Nanyang-Venture-Formula/NVF-Kicad/README.md

# NVF-Kicad
General Kicad Library for electrical components for use in NVF

## Setup

add `NVF_KICAD_DIR` alias to library where this directory is located
