Nanyang-Venture-Formula/NVF-Kicad/3dmodels/2.54mm/01x08-10.5mmLeg.step

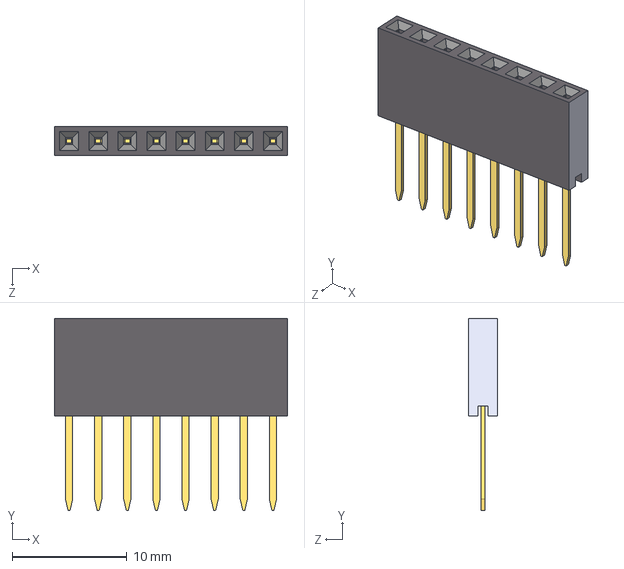
[picture p1: CAD file, 2024-02-09]
3dmodels/2.54mm/01x08-10.5mmLeg.step
20.3 x 16.8 x 2.54 mm
