Nanyang-Venture-Formula/NVF-Kicad/3dmodels/JST/PHD/B8B-PHDSS.step

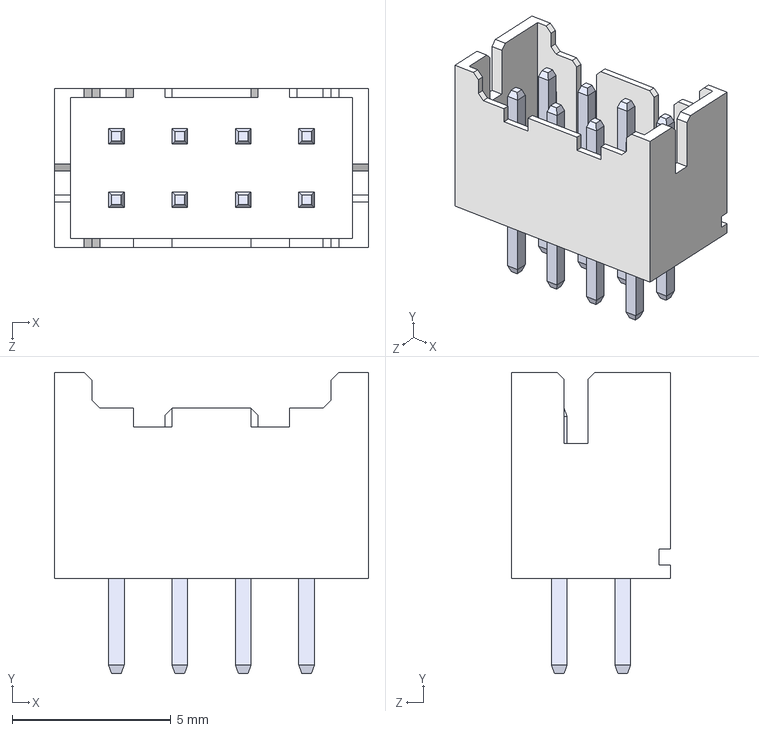
[picture p2: CAD file, 2024-02-05]
3dmodels/JST/PHD/B8B-PHDSS.step
9.90 x 9.50 x 5.00 mm
BxB-PHDSS_8
pin^BxB-PHDSS ass x 8
