Nanyang-Venture-Formula/NVF-Kicad/3dmodels/LED/7Segment-4Digits.step

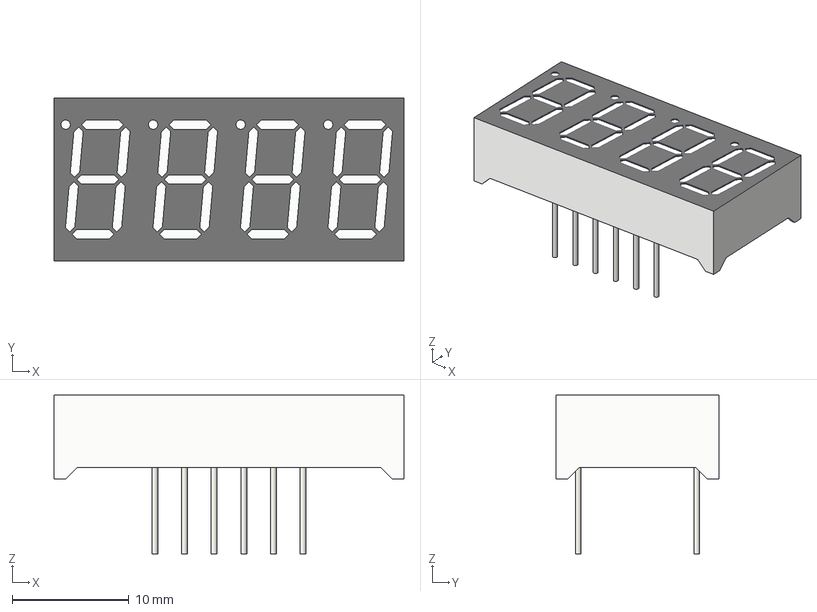
[picture p3: CAD file, 2024-02-09]
3dmodels/LED/7Segment-4Digits.step
30.0 x 14.0 x 13.6 mm
