Nanyang-Venture-Formula/NVF-Kicad/3dmodels/Potentiometer/3362P-1-103LF.step

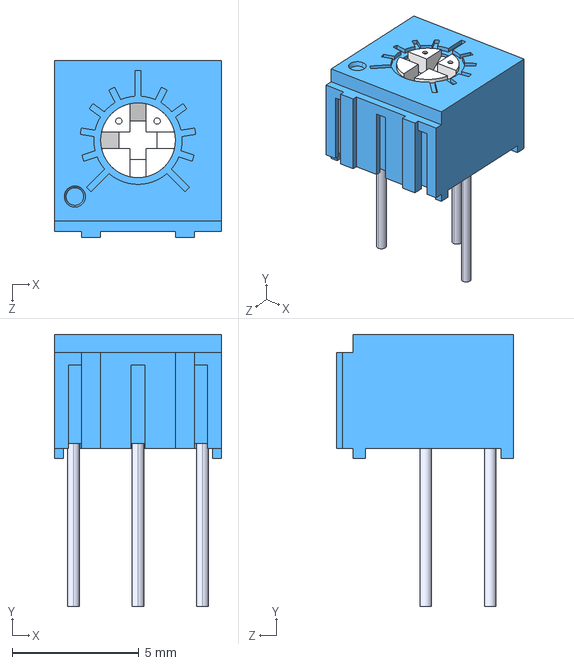
[picture p4: CAD file, 2024-02-09]
3dmodels/Potentiometer/3362P-1-103LF.step
6.60 x 10.7 x 6.99 mm
