Nanyang-Venture-Formula/NVF-Kicad/3dmodels/Rotary Encoder/EC11-THT-20K-thread-black.step

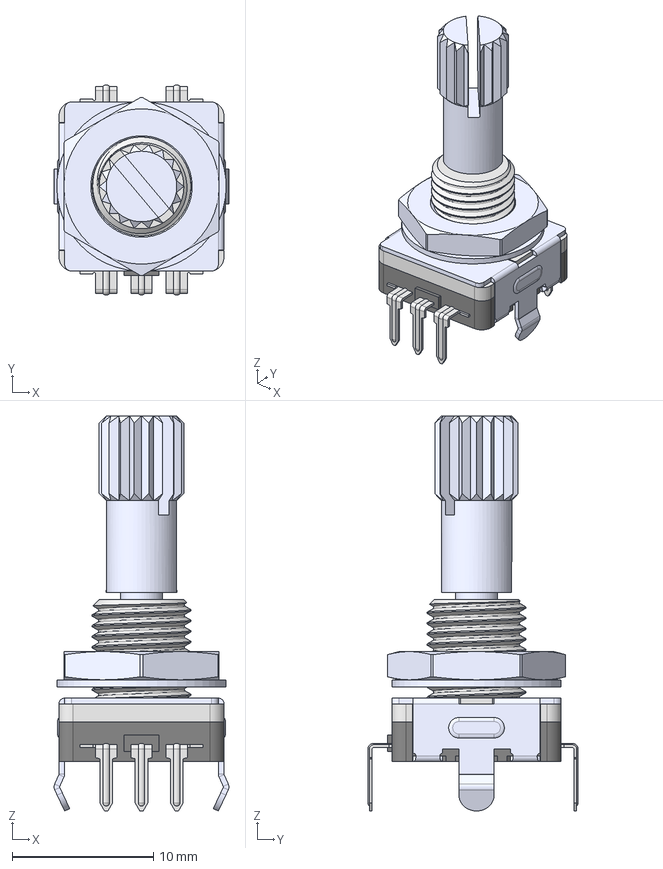
[picture p5: CAD file, 2024-02-09]
3dmodels/Rotary Encoder/EC11-THT-20K-thread-black.step
12.4 x 14.9 x 28.0 mm
Lb7 TH
20K
EC11-Housing-THT
