Nanyang-Venture-Formula/NVF-Kicad/3dmodels/SD/TF-01A.step

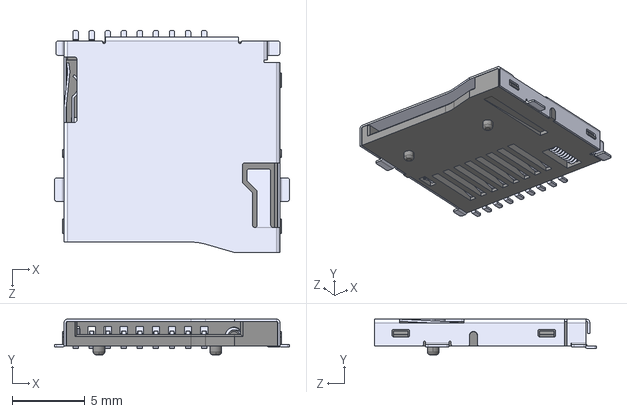
[picture p6: CAD file, 2024-01-23]
3dmodels/SD/TF-01A.step
16.1 x 2.45 x 15.2 mm
