Nanyang-Venture-Formula/NVF-Kicad/3dmodels/Switch/TS-1187A-B-A-B.step

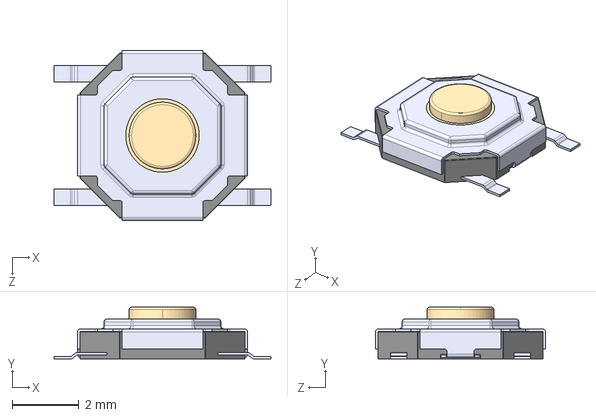
[picture p7: CAD file, 2024-01-23]
3dmodels/Switch/TS-1187A-B-A-B.step
6.50 x 1.55 x 5.10 mm
