Nanyang-Venture-Formula/NVF-Kicad/3dmodels/Fuse/Fuse-Holder/MCCQ-122.step

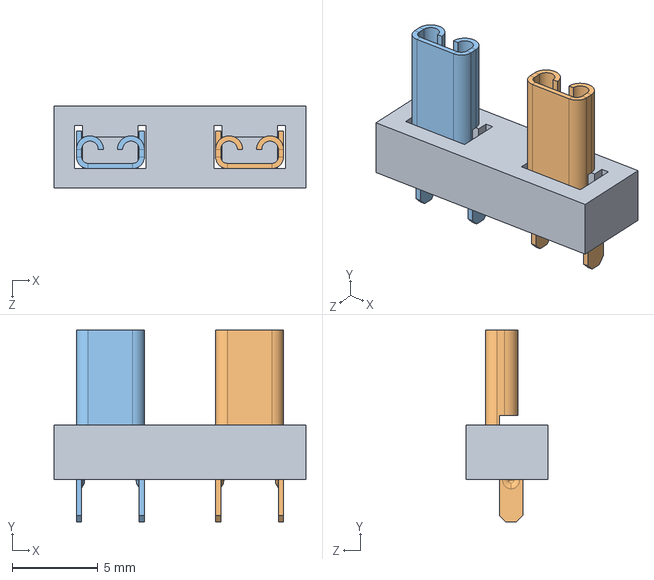
[picture p8: CAD file, 2024-02-05]
3dmodels/Fuse/Fuse-Holder/MCCQ-122.step
14.7 x 11.2 x 4.75 mm
