Nanyang-Venture-Formula/NVF-Kicad/3dmodels/JST/PHD/S8B-PHDSS.step

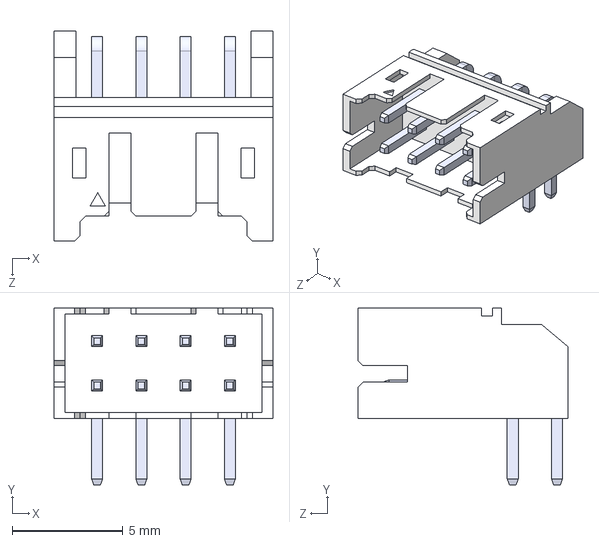
[picture p9: CAD file, 2024-02-05]
3dmodels/JST/PHD/S8B-PHDSS.step
9.90 x 8.00 x 9.50 mm
SxB-PHDSS_8
pin^SxB-PHDSS ass x 4
