Nanyang-Venture-Formula/NVF-Kicad/3dmodels/JST/PHD/B16B-PHDSS.step

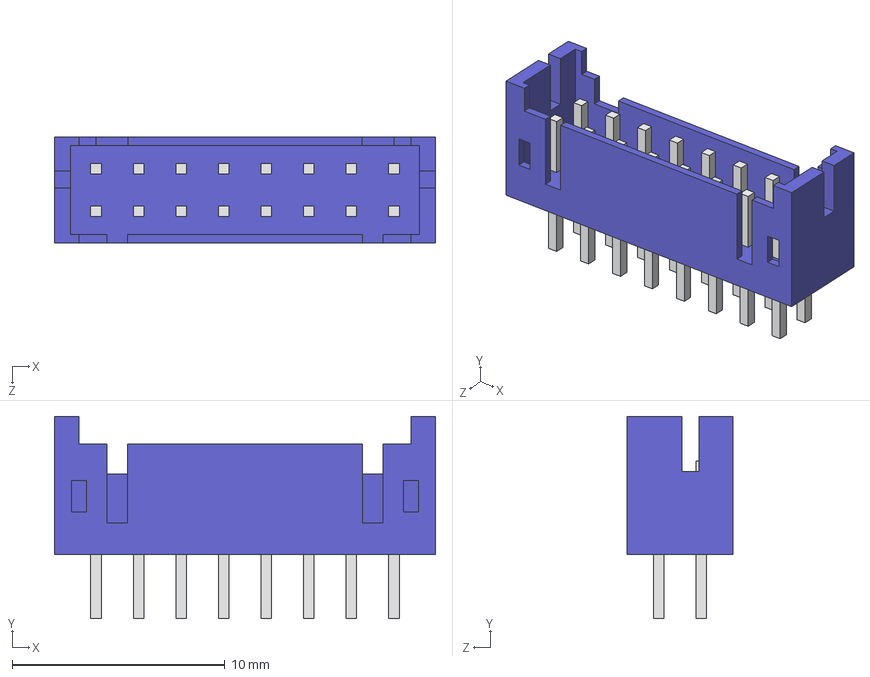
[picture p10: CAD file, 2024-01-23]
3dmodels/JST/PHD/B16B-PHDSS.step
17.9 x 9.50 x 5.00 mm
