Nanyang-Venture-Formula/NVF-Kicad/3dmodels/Fuse/Fuse-Holder/01550900M.step

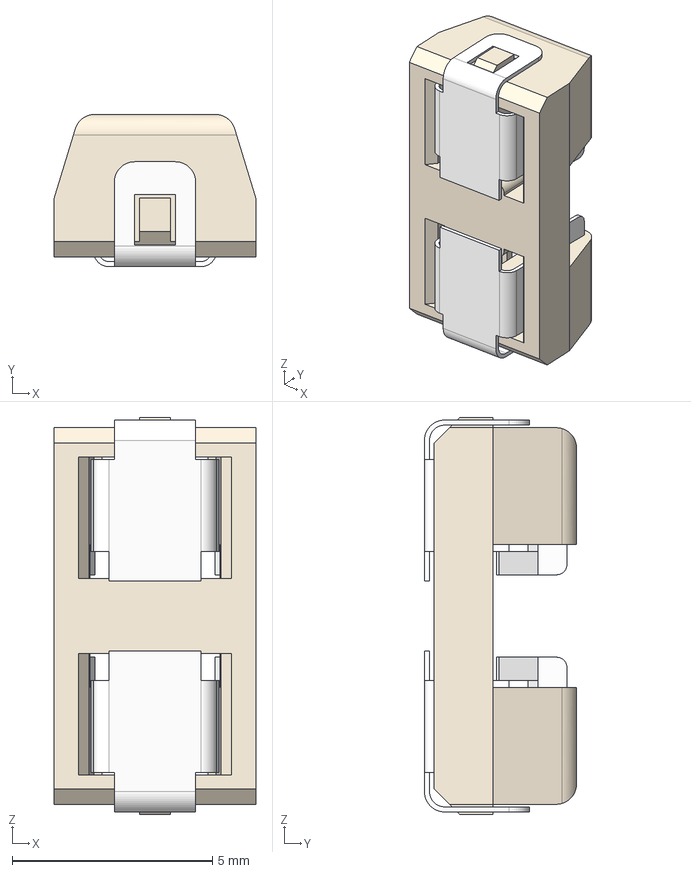
[picture p11: CAD file, 2024-02-28]
3dmodels/Fuse/Fuse-Holder/01550900M.step
5.03 x 3.80 x 9.91 mm
883-059_MIR
