Nanyang-Venture-Formula/NVF-Kicad/3dmodels/LCD/GMG12864-06D.step

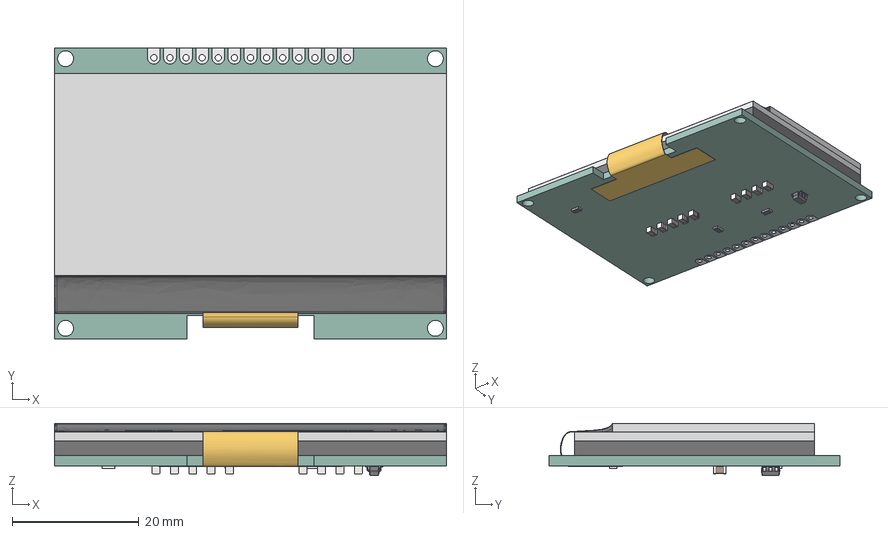
[picture p12: CAD file, 2024-02-09]
3dmodels/LCD/GMG12864-06D.step
61.8 x 45.8 x 8.25 mm
PCB
LED-box
Back glass
Front glass
Ribbon cable
Resin
Hole plates
C_0805_2012Metric x 9
SOT-23-6
R_0805_2012Metric x 3
