Nanyang-Venture-Formula/NVF-Kicad/3dmodels/Molex/Microfit/43045-2400.step

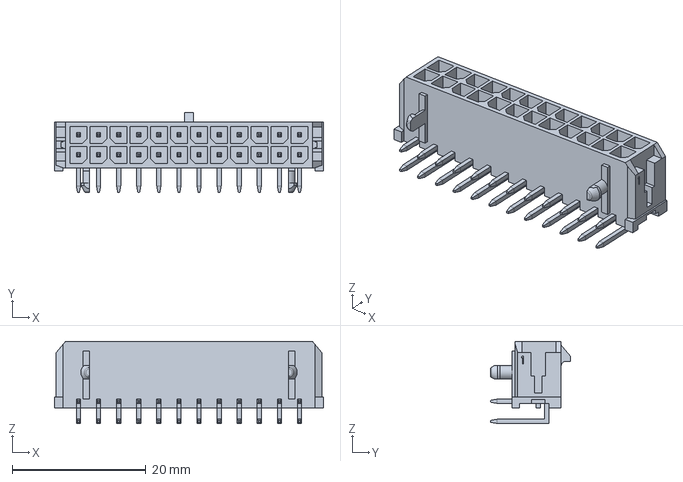
[picture p13: CAD file, 2024-02-09]
3dmodels/Molex/Microfit/43045-2400.step
40.1 x 11.9 x 12.2 mm
