Nanyang-Venture-Formula/NVF-Kicad/3dmodels/Molex/MiniFit/039281083.step

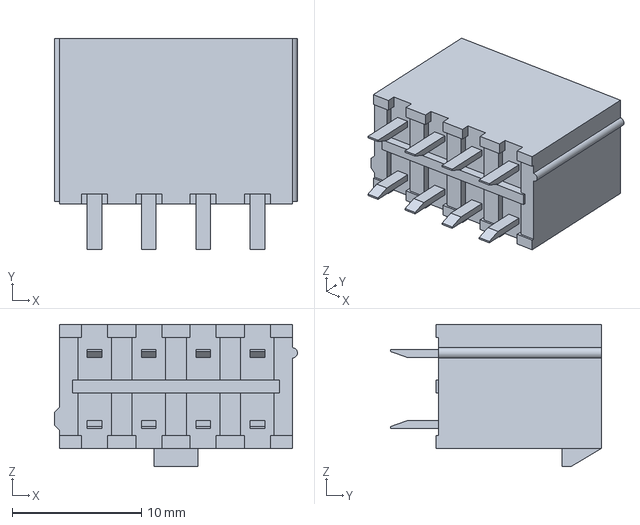
[picture p14: CAD file, 2024-04-01]
3dmodels/Molex/MiniFit/039281083.step
18.8 x 16.3 x 11.0 mm
