Nanyang-Venture-Formula/NVF-Kicad/3dmodels/Molex/Microfit/43045-2012.step

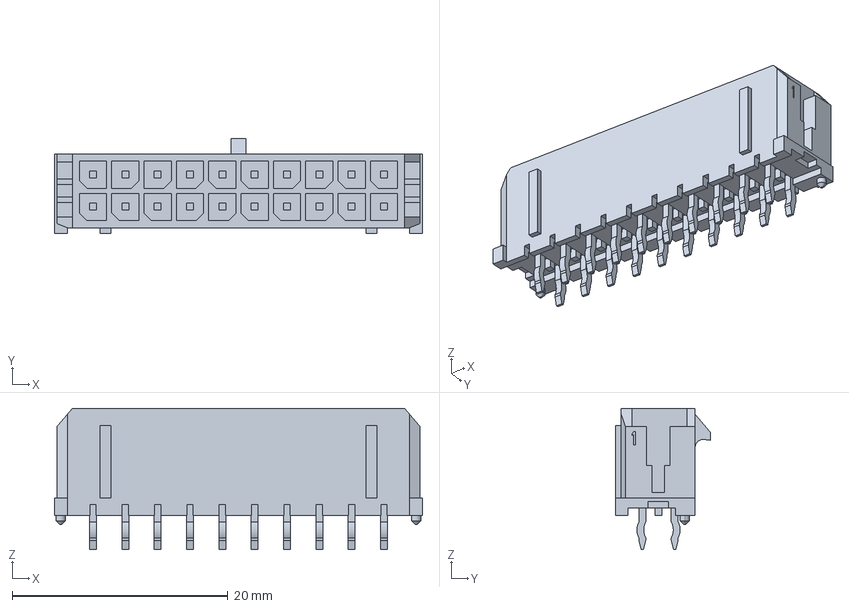
[picture p15: CAD file, 2024-02-05]
3dmodels/Molex/Microfit/43045-2012.step
34.1 x 8.77 x 13.1 mm
