Nanyang-Venture-Formula/NVF-Kicad/3dmodels/Molex/MiniFit/039291088.step

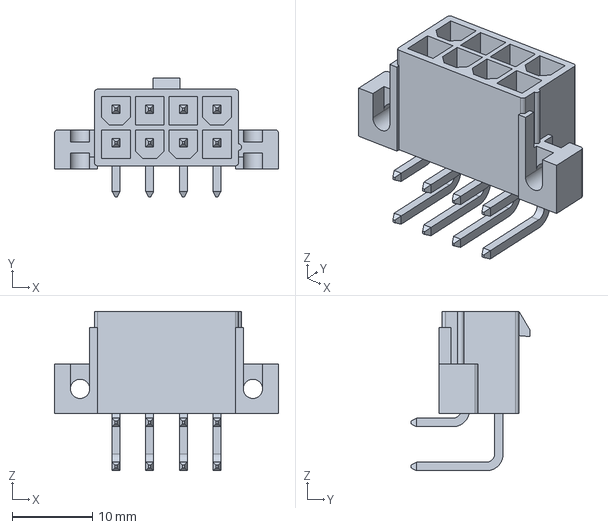
[picture p16: CAD file, 2024-04-01]
3dmodels/Molex/MiniFit/039291088.step
28.0 x 14.9 x 19.9 mm
