Nanyang-Venture-Formula/NVF-Kicad/3dmodels/Molex/Microfit/43045-0812.step

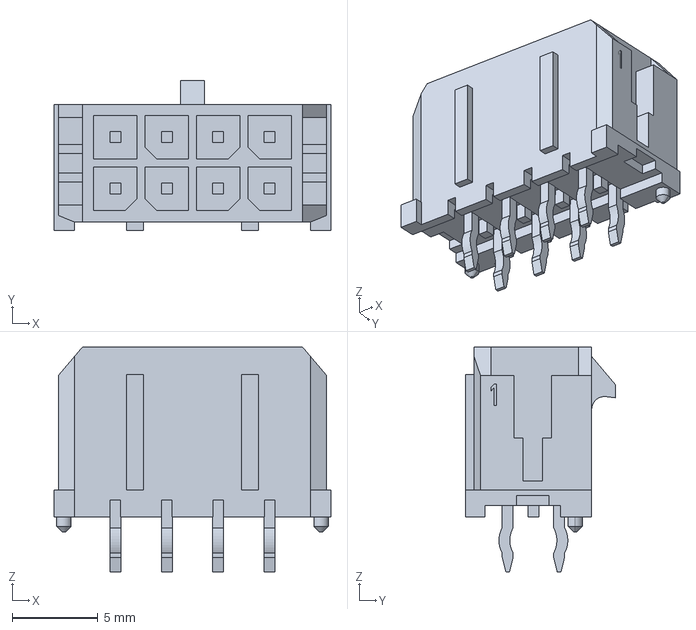
[picture p17: CAD file, 2024-02-05]
3dmodels/Molex/Microfit/43045-0812.step
16.1 x 8.77 x 13.1 mm
