Nanyang-Venture-Formula/NVF-Kicad/3dmodels/Molex/MiniFit/039296028.step

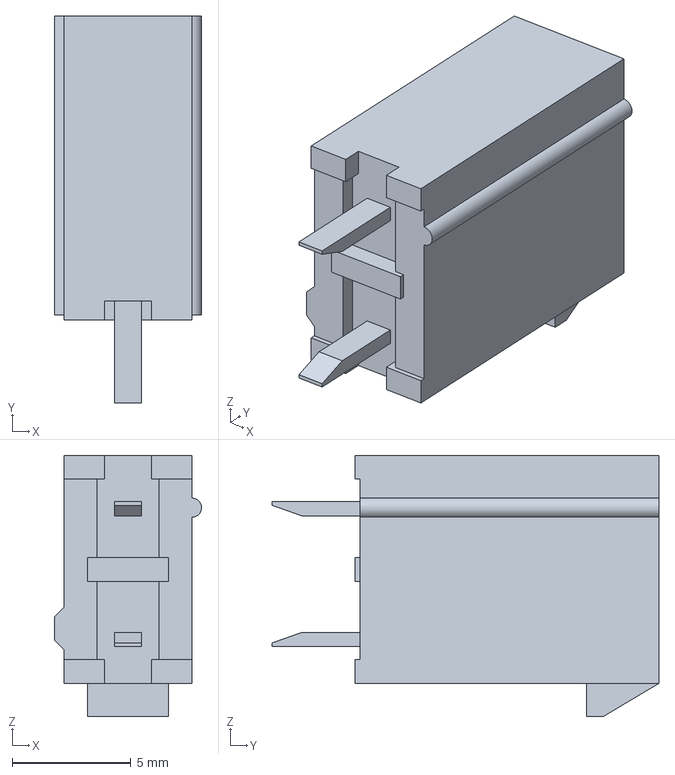
[picture p18: CAD file, 2024-04-01]
3dmodels/Molex/MiniFit/039296028.step
6.20 x 16.3 x 11.0 mm
