Nanyang-Venture-Formula/NVF-Kicad/(list of files, cad)

Other CAD files:
3dmodels/Molex/Microfit/43045-2427.step
3dmodels/Molex/Microfit/43650-0415.step
