Nanyang-Venture-Formula/NVF-Kicad/(commit log)

2023-09-26 added WeAct Pi Pico
2023-10-03 Added STM32G431CBT6
    [LQFP48-7x7mm.step]
2023-10-08 added Power Modules
    [LMR14050SDDAR.step]
2023-11-01 added footprints
2023-11-14 added files for 1 Job
    [DM3CS-SF.step]
2023-12-20 added 02x04 headers and sockets
    [CM251X.STEP]
2024-01-23 removed unused footprints
    [8PCV-02-006.step]
2024-01-24 added models
    [43045-2427.step, CM251X.STEP, DM3CS-SF.step, LMR14050SDDAR.step, LQFP48-7x7mm.step]
2024-01-25 updated rsc
    [S8B-PHDSS-56544.step]
2024-02-05 added rscs
    [3362P-1-103LF.step, 4Digit_7Segment_LED_Display v8.step, LDQ-M3604RI.step]
2024-02-05 throw all
    [43045-2427.step, 8PCV-02-006.step, B16B-PHDSS-B.STEP, TF-01A.step, TS-1187A-B-A-B.step, molex_mini-fit_jr_5566-24a_2x12.step]
2024-02-09 added rsc
    [01x08-10.5mmLeg.step, 3362P-1-103LF.step, 43045-2400.step, 7Segment-4Digits.step, EC11-THT-20K-thread-black.step, GMG12864-06D.step]
2024-02-13 updated small-general sym
    [3362P-1-103LF.step]
2024-02-28 updated fuse
    [01550900M.step]
2024-04-01 updated footprints
    [039281083.step, 039291088.step, 039296028.step]
